Elecrow-RD/Elecrow-RP2350-Pico-W5-Board/Schematic & PCB/Pico2 W5_V1.0_20240830.pdf

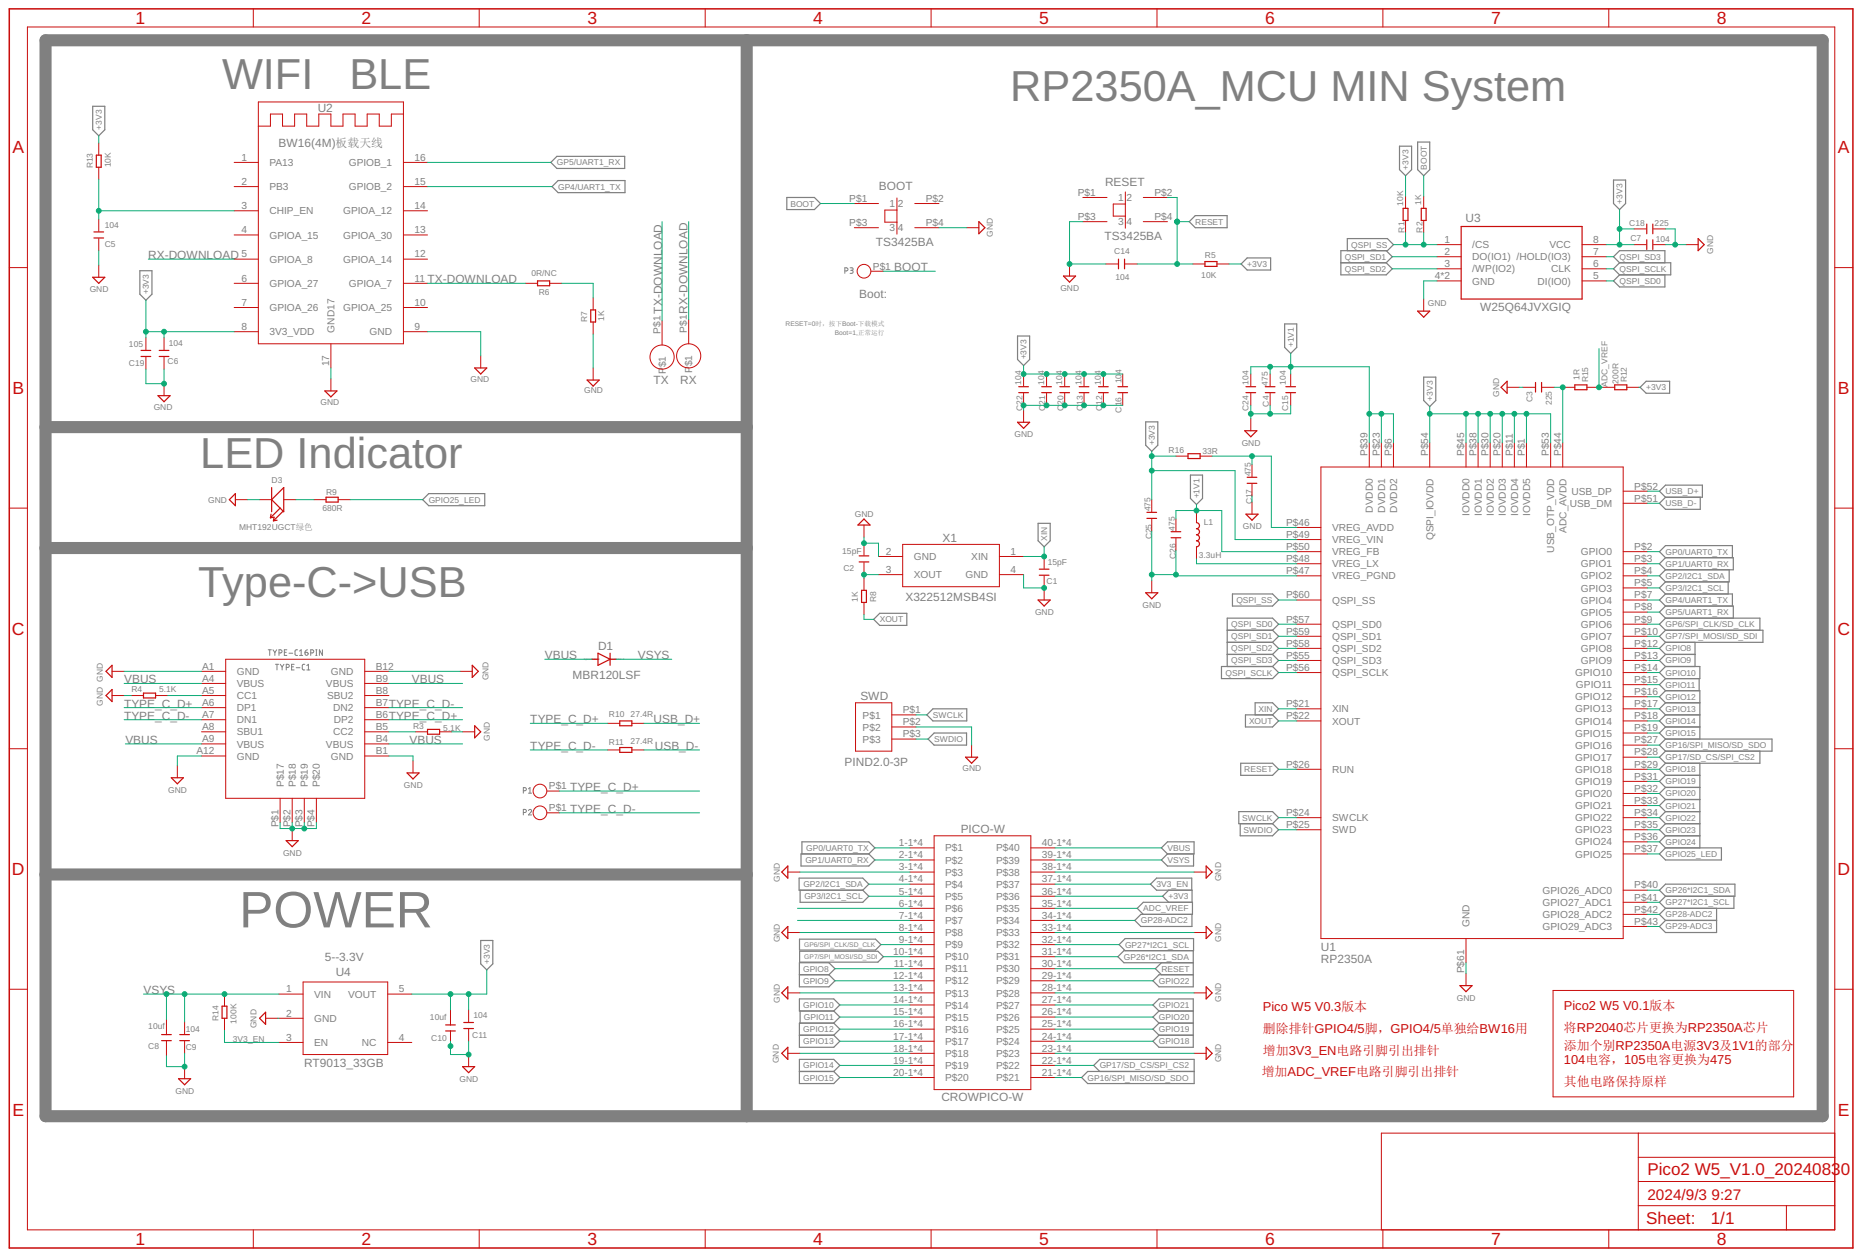
[picture p1: page 1]

Boot=1,正常运行 WIFI BLE

Boot: RESET=0时，按下Boot-下载模式

GND GND
