Elecrow-RD/Elecrow-RP2350-Pico-W5-Board/code/Arduino_Code/Examples/Blink/Blink.ino

#define LED 16

// the setup function runs once when you press reset or power the board
void setup() {
    // initialize digital pin LED as an output.
  pinMode(LED, OUTPUT);
}

// the loop function runs over and over again forever
void loop() {
  digitalWrite(LED, HIGH);   // turn the LED on (HIGH is the voltage level)
  delay(1000);              // wait for a second          
  digitalWrite(LED, LOW);    // turn the LED off by making the voltage LOW
  delay(1000);              // wait for a second         
}
